sensille/conan_board/(threads)

Thread 2 (2020-06-11):

PWM11/12 labeled wrong in text

crazyimp, 2020-06-11:
PWM10 text label exists two times, text on JP4 indicates PWM12/13. What is correct?

Thread 3 (2024-12-10):

Hello, how is your conan_board built, how is mcu firmware generated, and FPGA firmware, are there any tutorials

chinaboy2277, 2024-12-10:
Hello, how is your conan_board built, how is mcu firmware generated, and FPGA firmware, are there any tutorials

sensille, 2024-12-10:
Hi, thanks for your interest in this board. I haven't done any firmware development in the past years, though I'm still using the board in my printer, but with a pretty old version of klipper.
Building the board is expensive, as you have to have the PCBs made. You also need a reflow oven or at least a hot plate for the BGA. If you really want to do all that, I can explain how to build the firmware, it is in the conan_fpga repository.

chinaboy2277, 2024-12-10:
Hello, I want to build this project, I am very interested in this project,

chinaboy2277, 2024-12-11:
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
Hello, I have registered. How can I contact you or find you?

sensille, 2024-12-11:
Hi, not LibraIrc, but Libera https://libera.chat/ thanks.

chinaboy2277, 2024-12-11:
Okay, I'll give it another try.

chinaboy2277, 2024-12-11:
Cycling to next server in Libera.Chat...
* Disconnected ()
* Looking up newserver
* Unknown host. Maybe you misspelled it?
 Cycling to next server in Libera.Chat...
* Disconnected ()
* Looking up irc.libera.chat
* Connecting to irc.libera.chat (130.185.232.126:6697)
* * Subject: /C=US/O=Internet Security Research Group/CN=ISRG Root X1
* * Issuer: /C=US/O=Internet Security Research Group/CN=ISRG Root X1
* * Subject: /C=US/O=Let's Encrypt/CN=E6
* * Issuer: /C=US/O=Internet Security Research Group/CN=ISRG Root X1
* * Subject: /CN=copper.libera.chat
* * Issuer: /C=US/O=Let's Encrypt/CN=E6
* * Certification info:
*   Subject:
*     CN=copper.libera.chat
*   Issuer:
*     C=US
*     O=Let's Encrypt
*     CN=E6
*   Public key algorithm: id-ecPublicKey (384 bits)
*   Sign algorithm ecdsa-with-SHA384
*   Valid since Oct 14 05:07:06 2024 GM to Jan 12 05:07:05 2025 GM
* * Cipher info:
*   Version: TLSv1.3, cipher TLS_AES_256_GCM_SHA384 (256 bits)
* Connected. Now logging in.
* *** Checking Ident
* *** Looking up your hostname...
* *** Couldn't look up your hostname
* *** No Ident response

sensille, 2024-12-11:
I don't know what's wrong there, maybe you can just use the webchat for a start.

chinaboy2277, 2024-12-11:
Okay, I'll look into the issue first and get back to you once I've resolved it.

sensille, 2025-01-02:
Hi, which hardware? I've seen that you joined at that time, but was too late to reach out to you.
