sensille/conan_board/conan.pdf

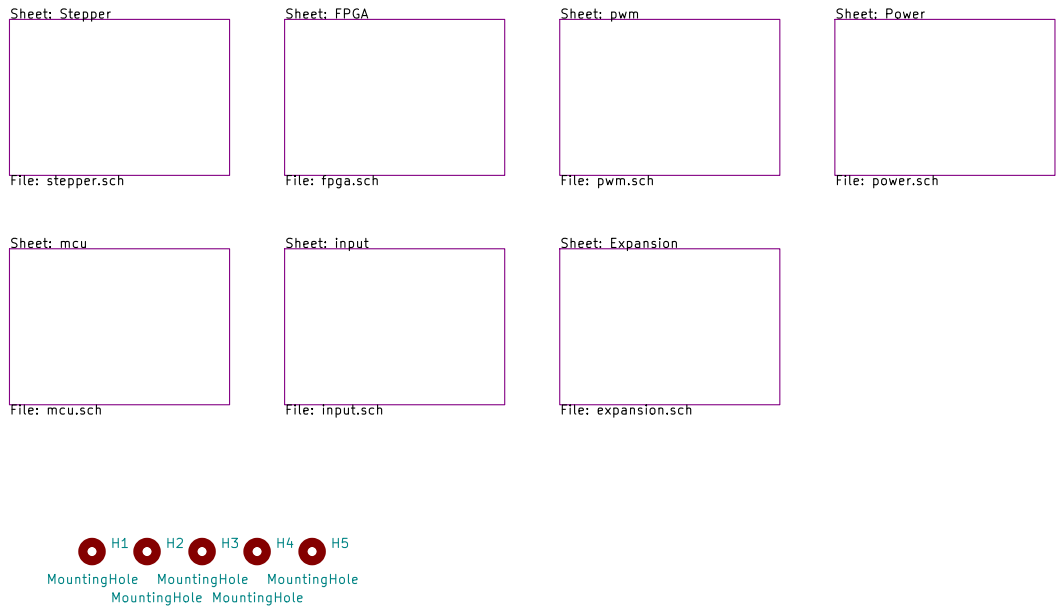
[picture p1: page 1]

Sheet: Power File: power.sch Sheet: FPGA

Id: 1/14 Title: File: conan.sch Sheet: /

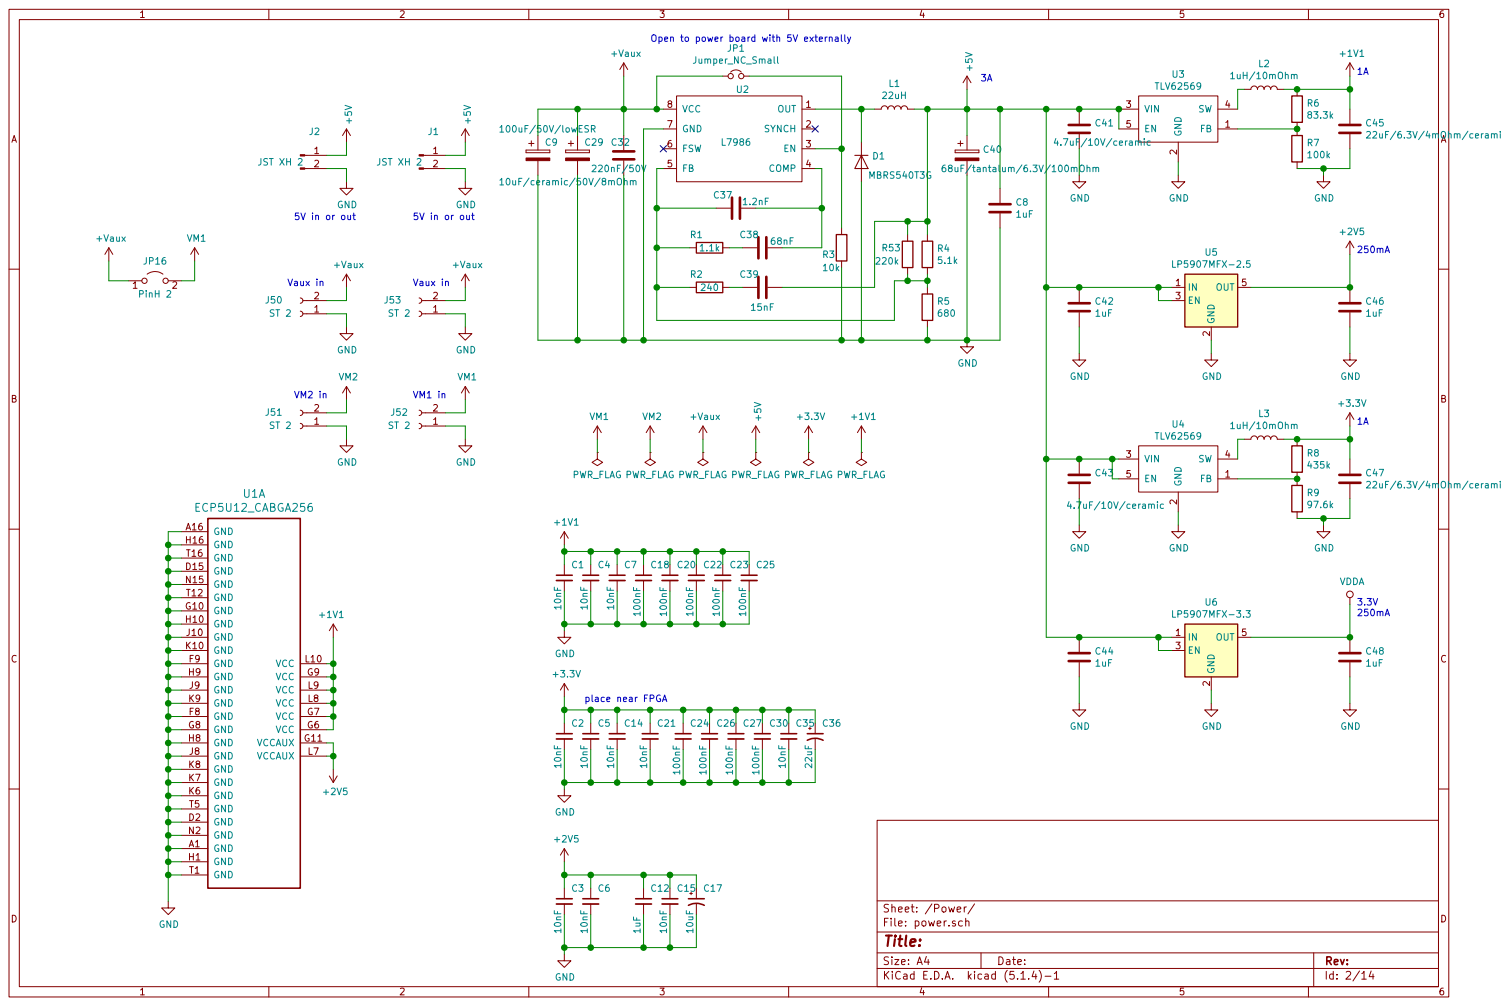
[picture p2: page 2]

3A Open to power board with 5V externally

File: power.sch Sheet: /Power/
Id: 2/14 Title:

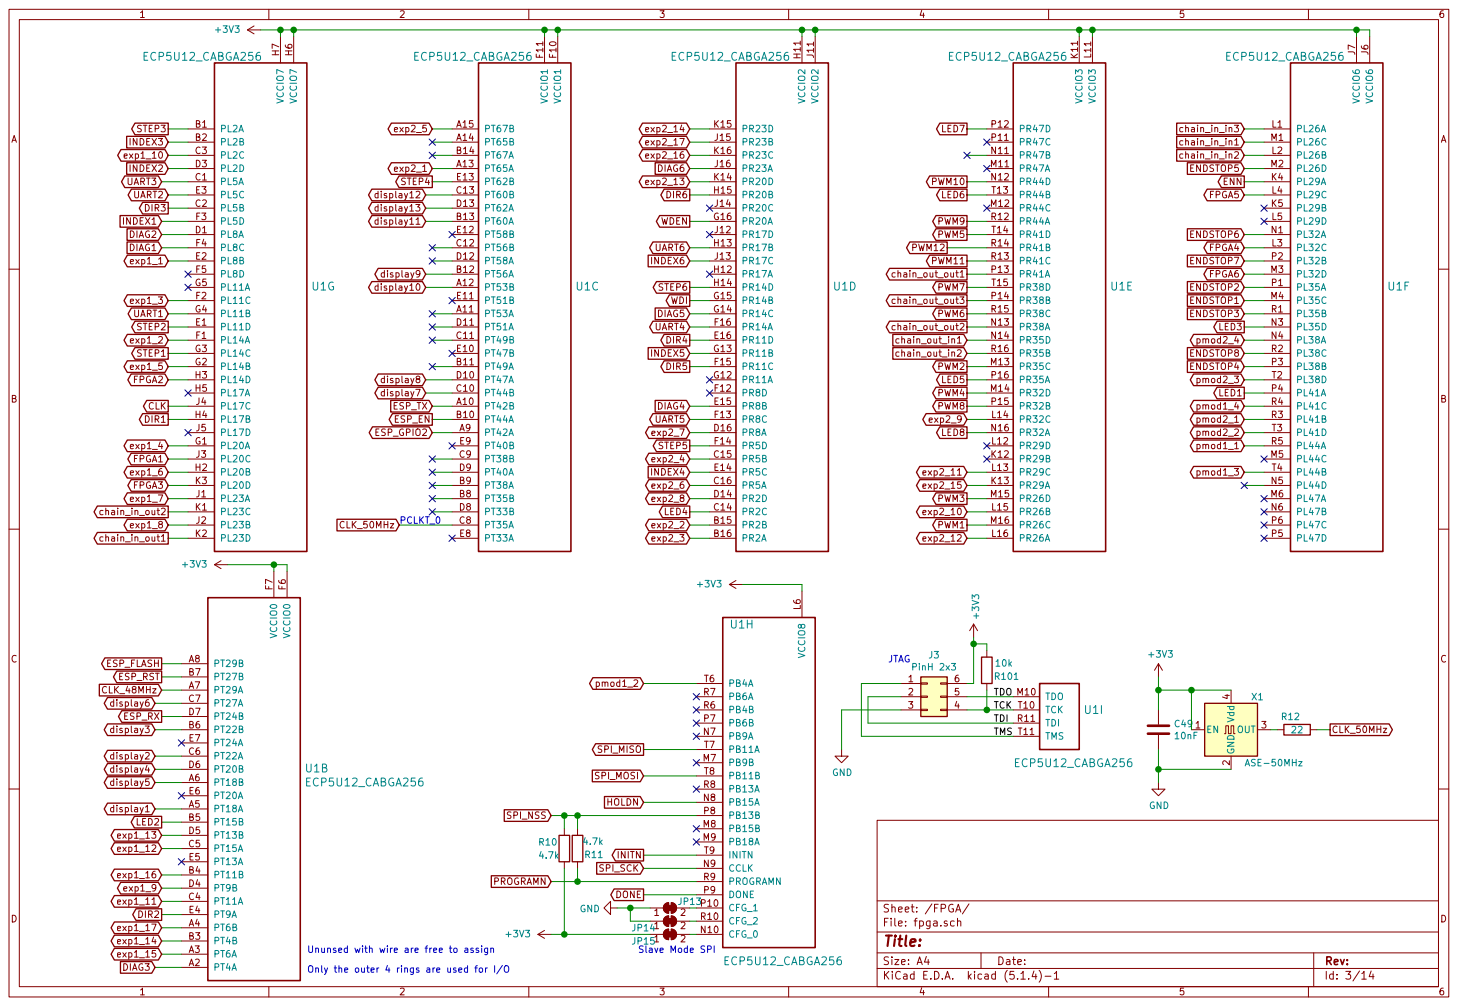
[picture p3: page 3]

TDI TMS Ununsed with wire are free to assign

Slave Mode SPI Only the outer 4 rings are used for I/O

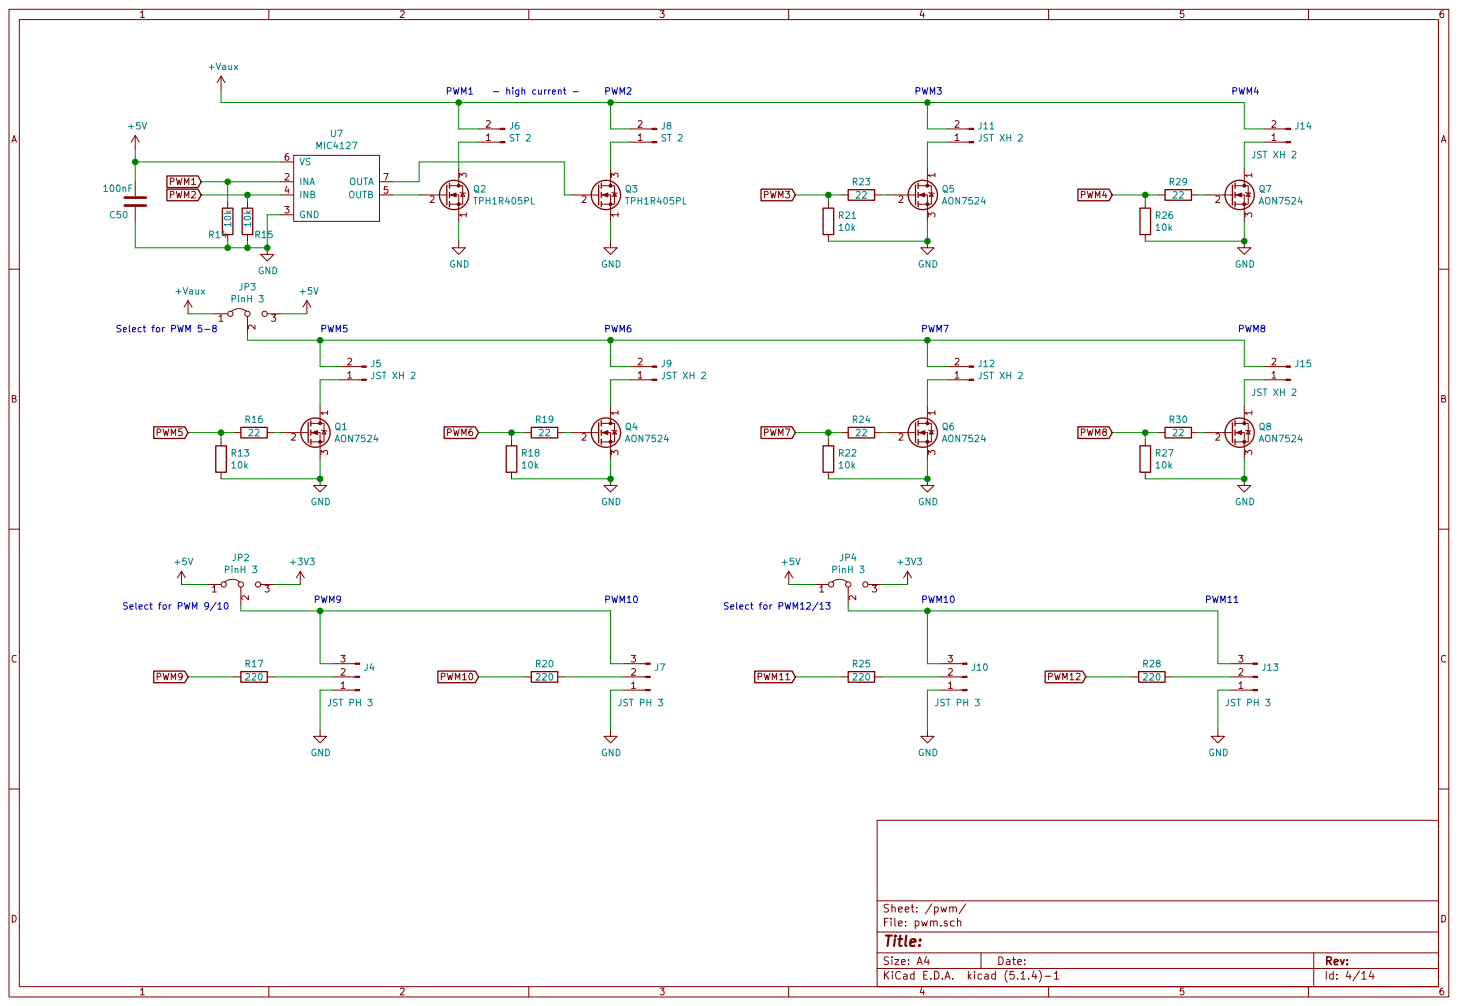
[picture p4: page 4]

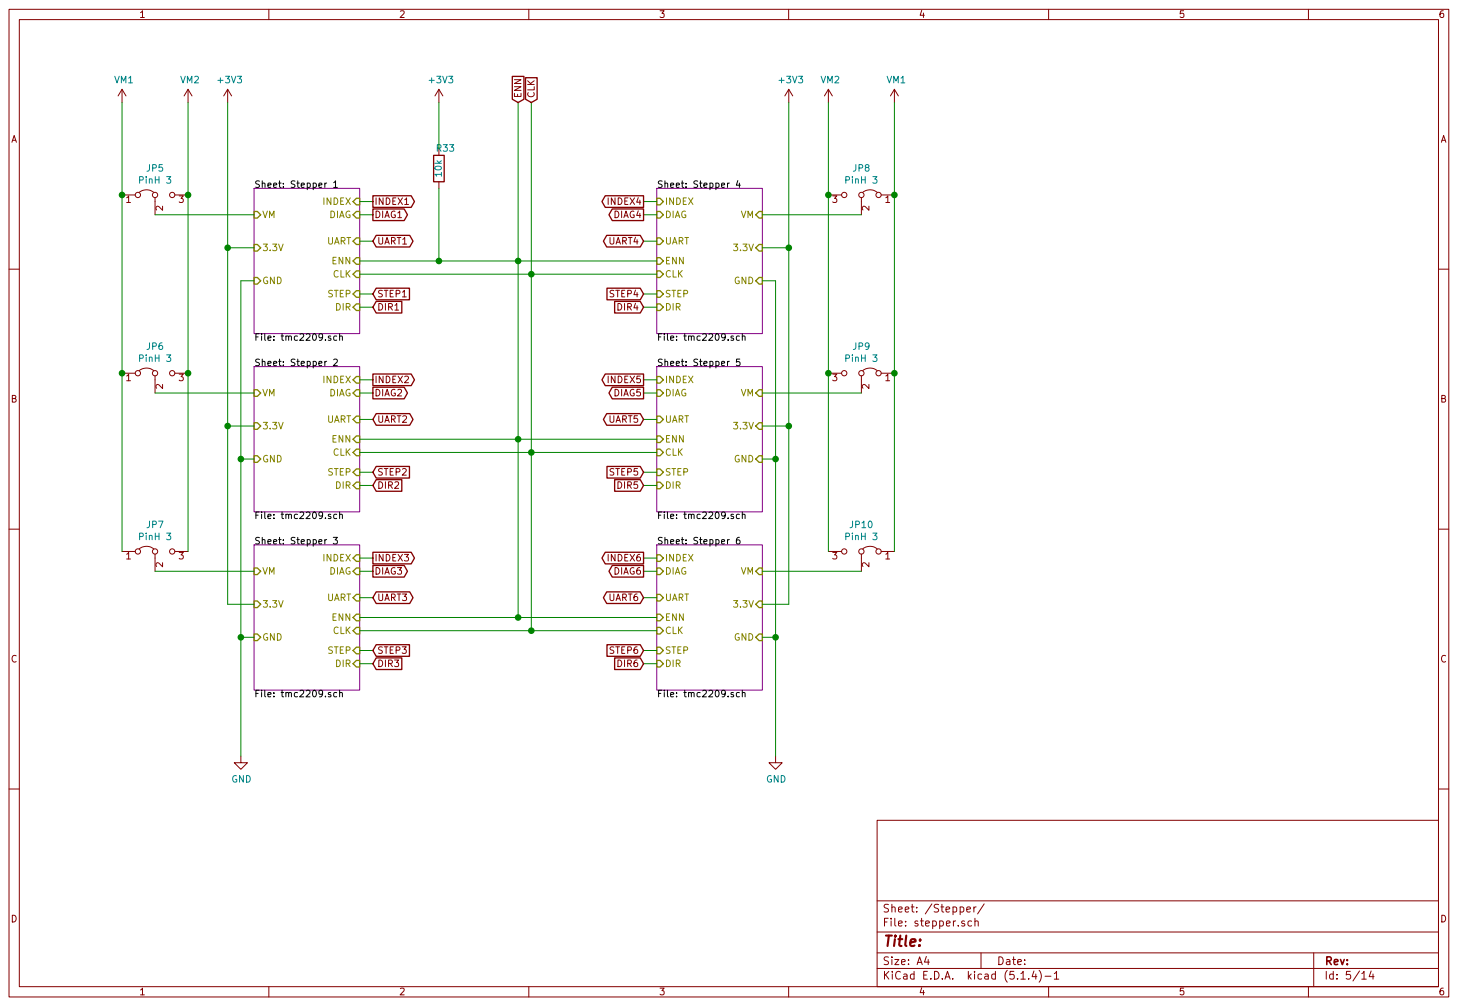
[picture p5: page 5]

Sheet: Stepper 1 File: tmc2209.sch ENN

Sheet: Stepper 4 File: tmc2209.sch ENN
UART DIAG

3.3V GND
Sheet: Stepper 5 File: tmc2209.sch ENN
INDEX

Sheet: Stepper 2 File: tmc2209.sch ENN

Sheet: Stepper 6 File: tmc2209.sch ENN

Sheet: Stepper 3 File: tmc2209.sch ENN

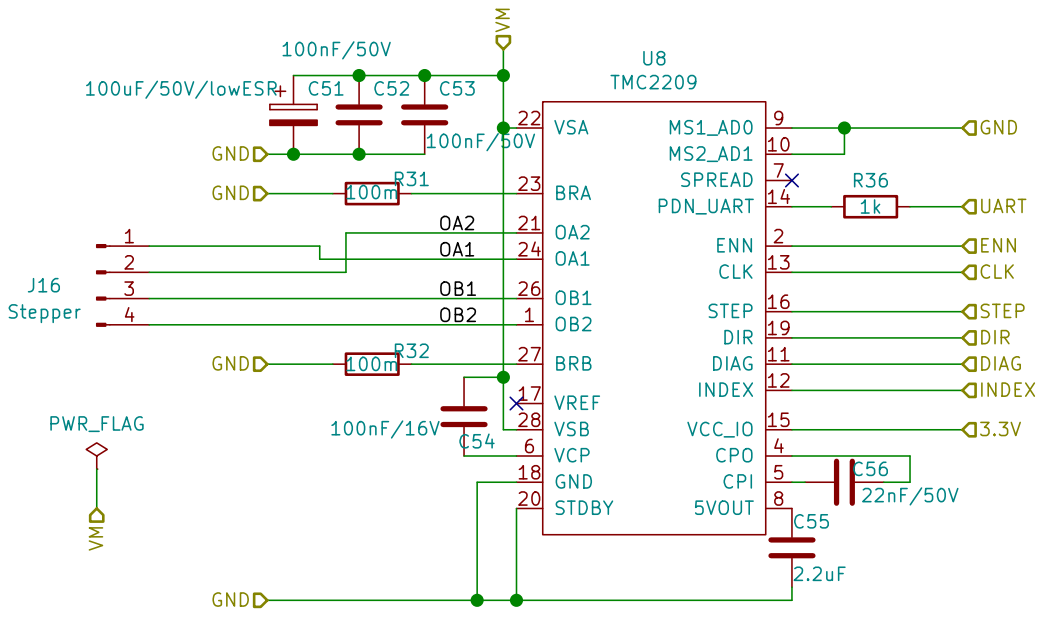
[picture p6: page 6]

Id: 6/14 Title: File: tmc2209.sch Sheet: /Stepper/Stepper 3/

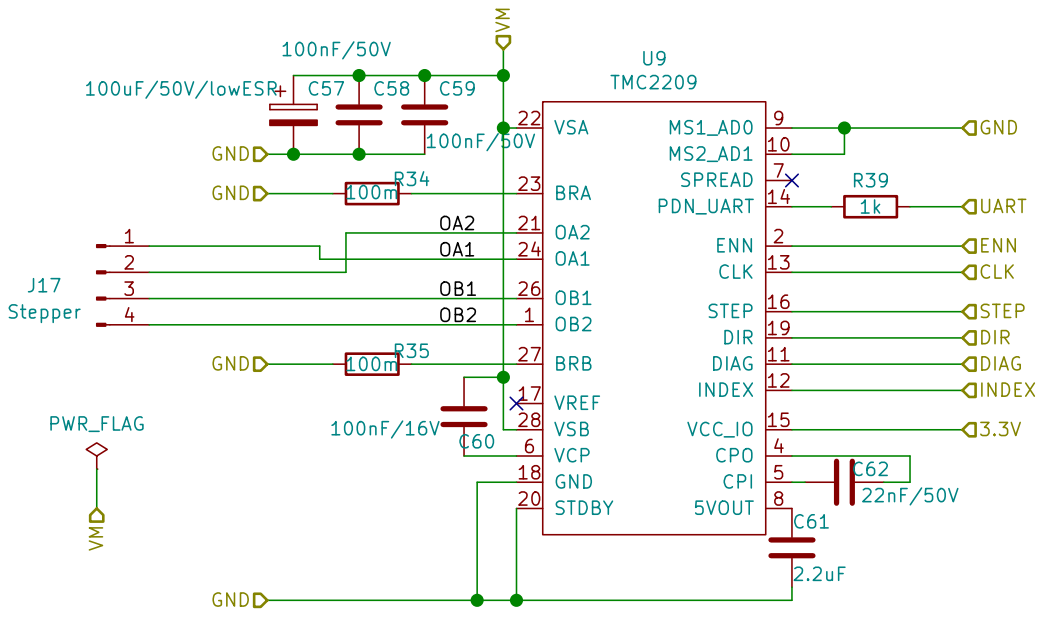
[picture p7: page 7]

Id: 7/14 Title: File: tmc2209.sch Sheet: /Stepper/Stepper 2/

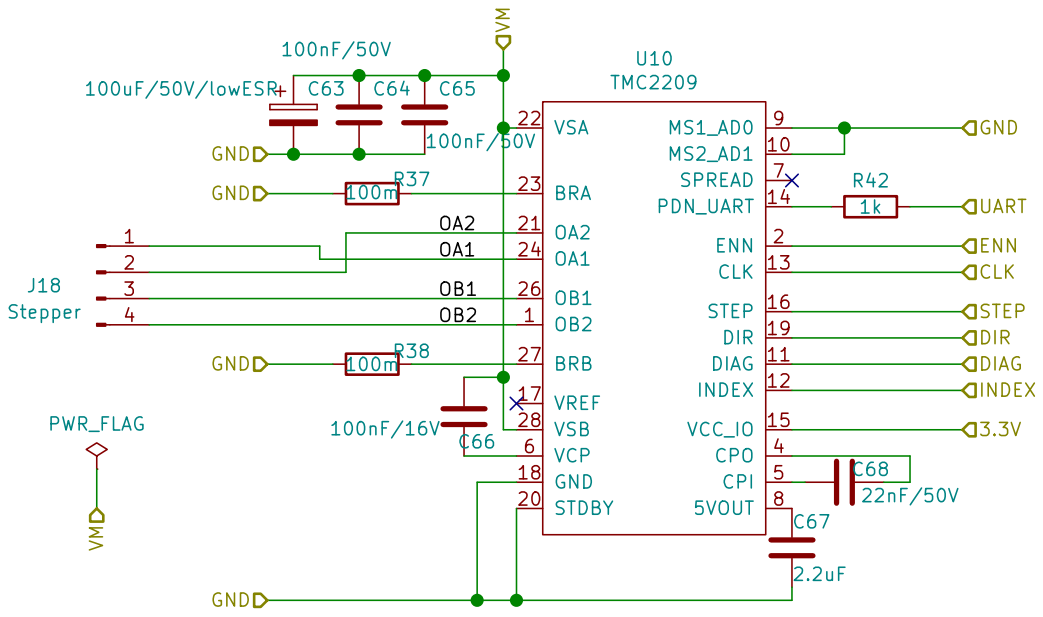
[picture p8: page 8]

Id: 8/14 Title: File: tmc2209.sch Sheet: /Stepper/Stepper 1/

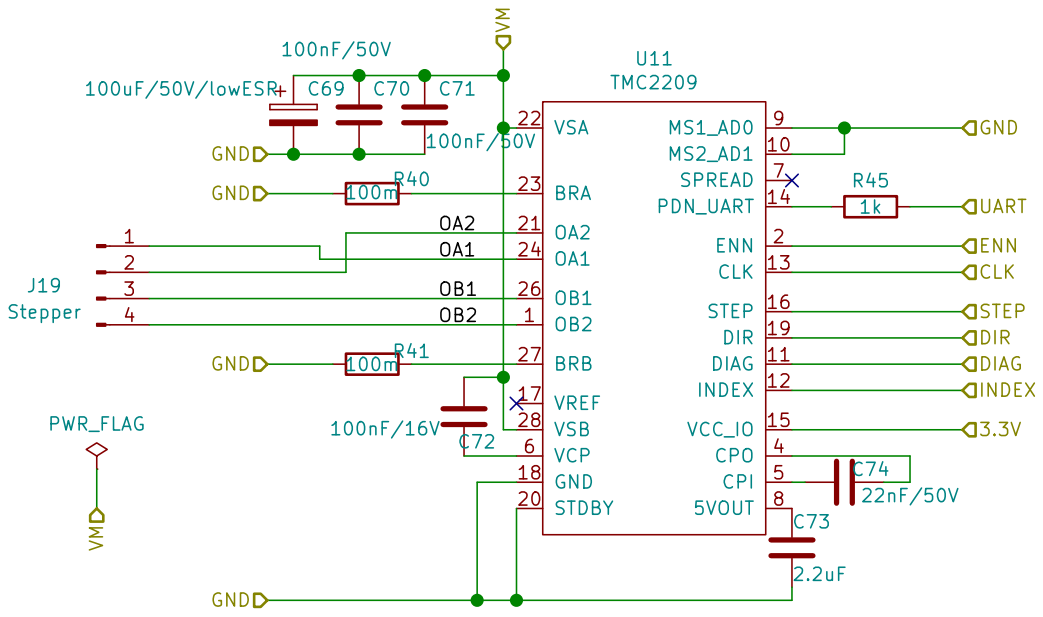
[picture p9: page 9]

Id: 9/14 Title: File: tmc2209.sch Sheet: /Stepper/Stepper 6/

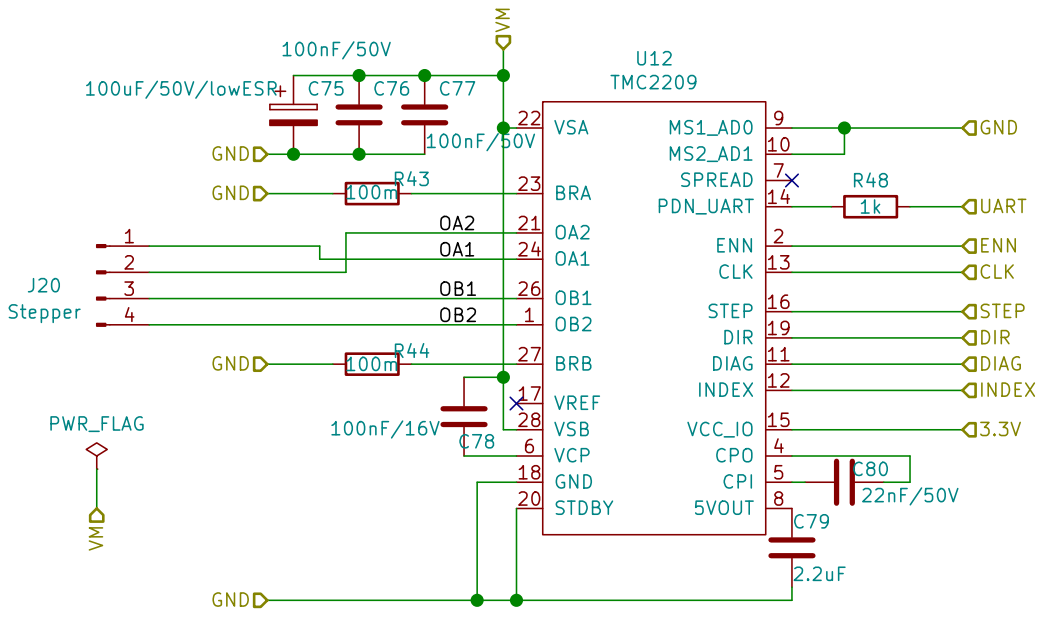
[picture p10: page 10]

Id: 10/14 Title: File: tmc2209.sch Sheet: /Stepper/Stepper 5/

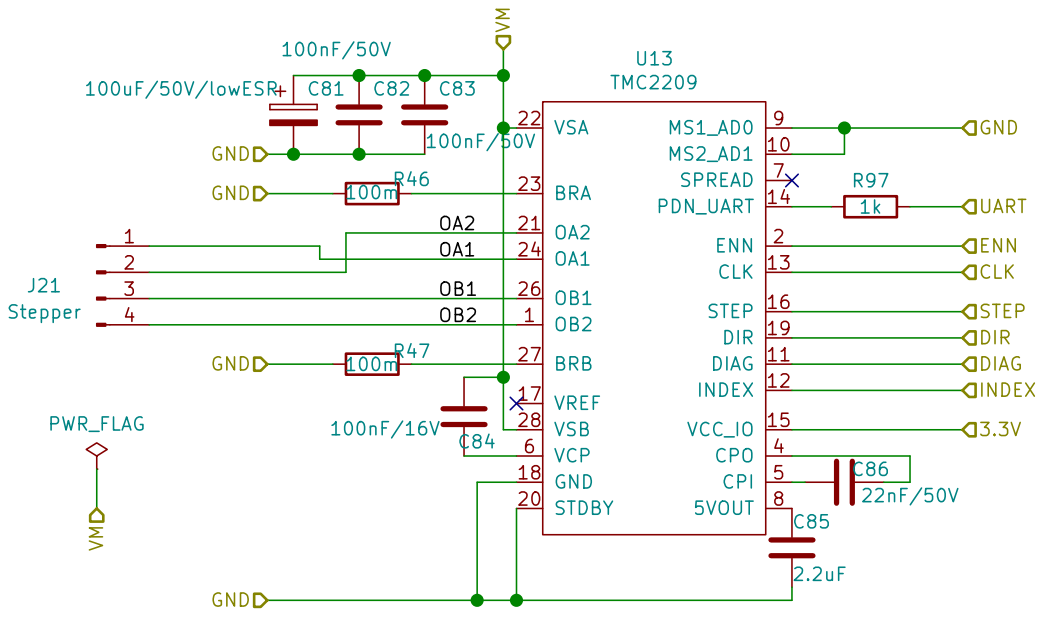
[picture p11: page 11]

Id: 11/14 Title: File: tmc2209.sch Sheet: /Stepper/Stepper 4/

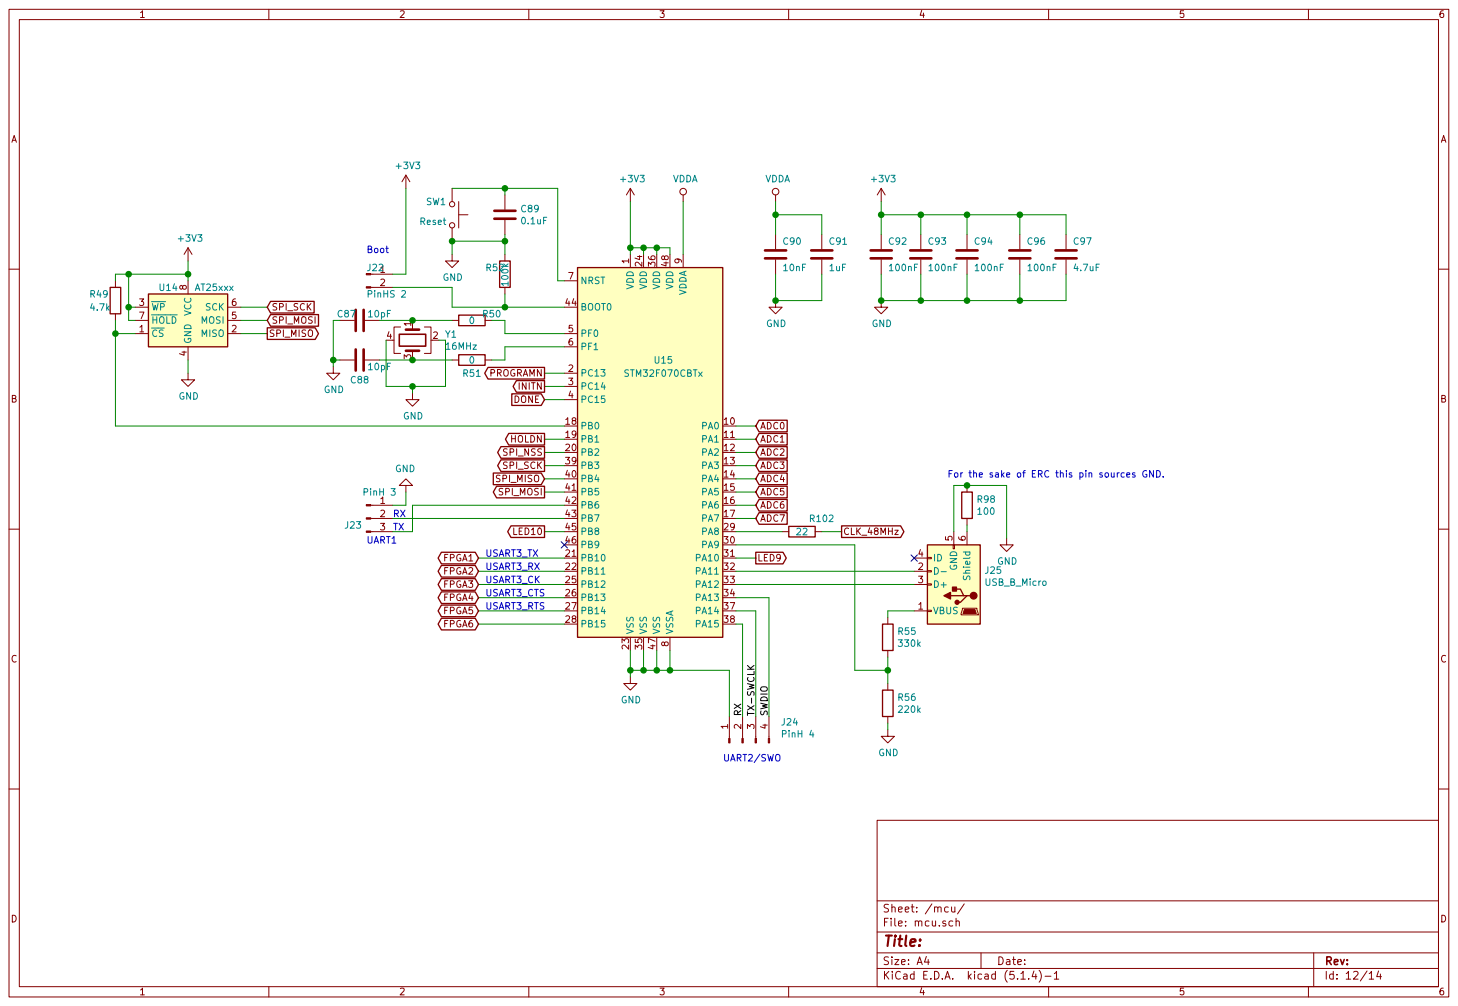
[picture p12: page 12]

1 VDD 24 VDD 36 VDD 48 VDDA

9 VSS 23 VSS 35 VSS 47 VSSA

4 MOSI 5 SCK 6 HOLD 7 VCC

For the sake of ERC this pin sources GND. RX

Id: 12/14 Title: File: mcu.sch Sheet: /mcu/

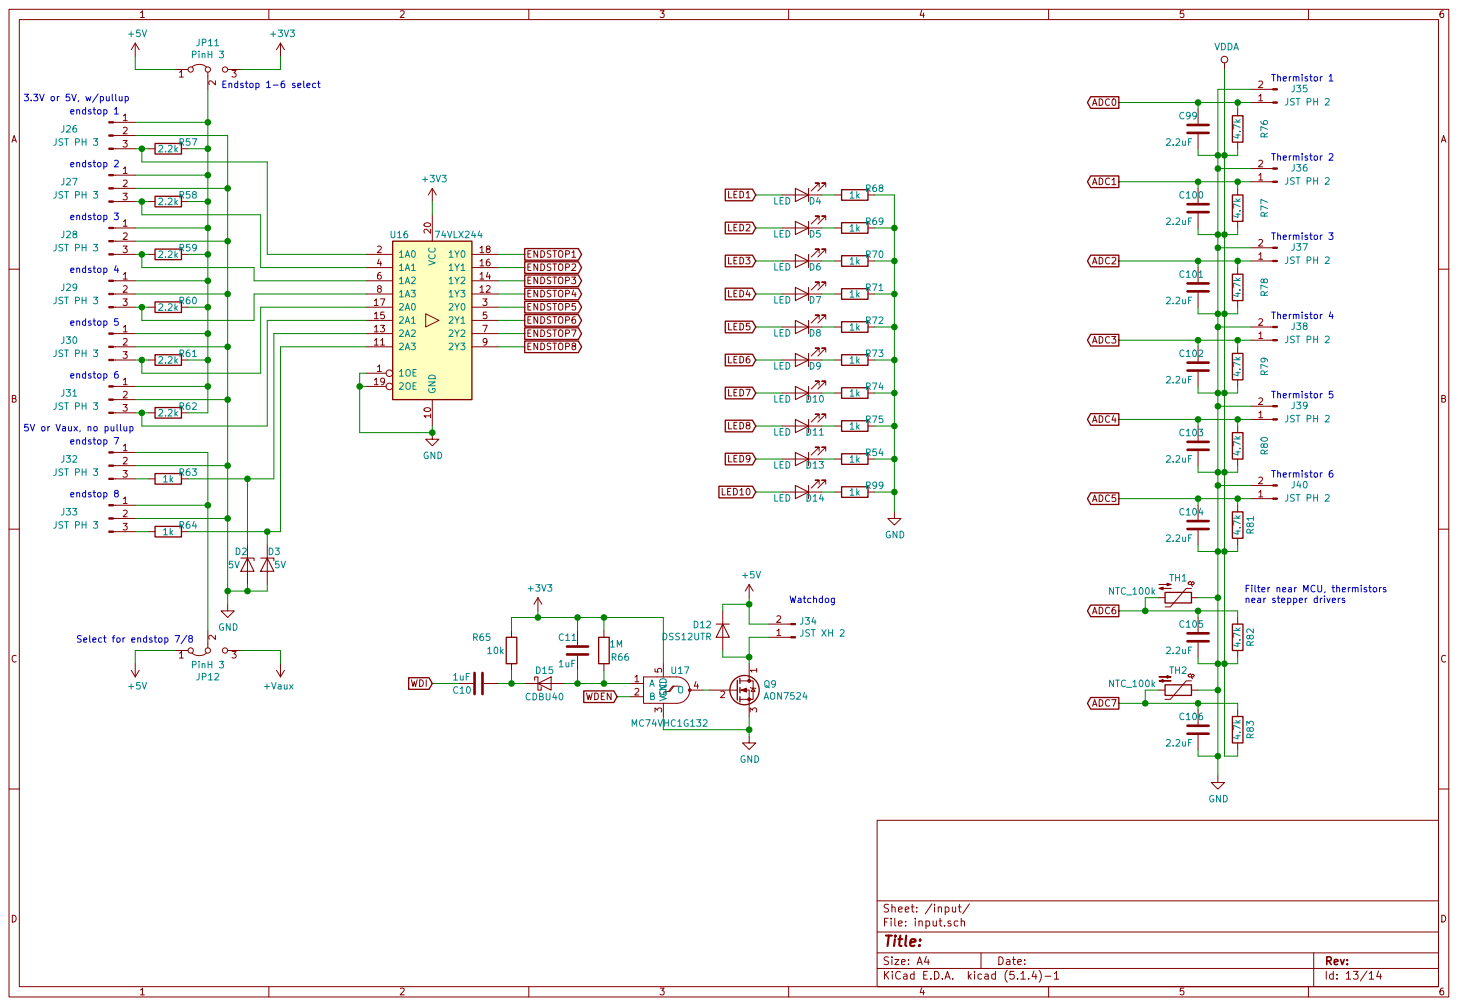
[picture p13: page 13]

5V or Vaux, no pullup

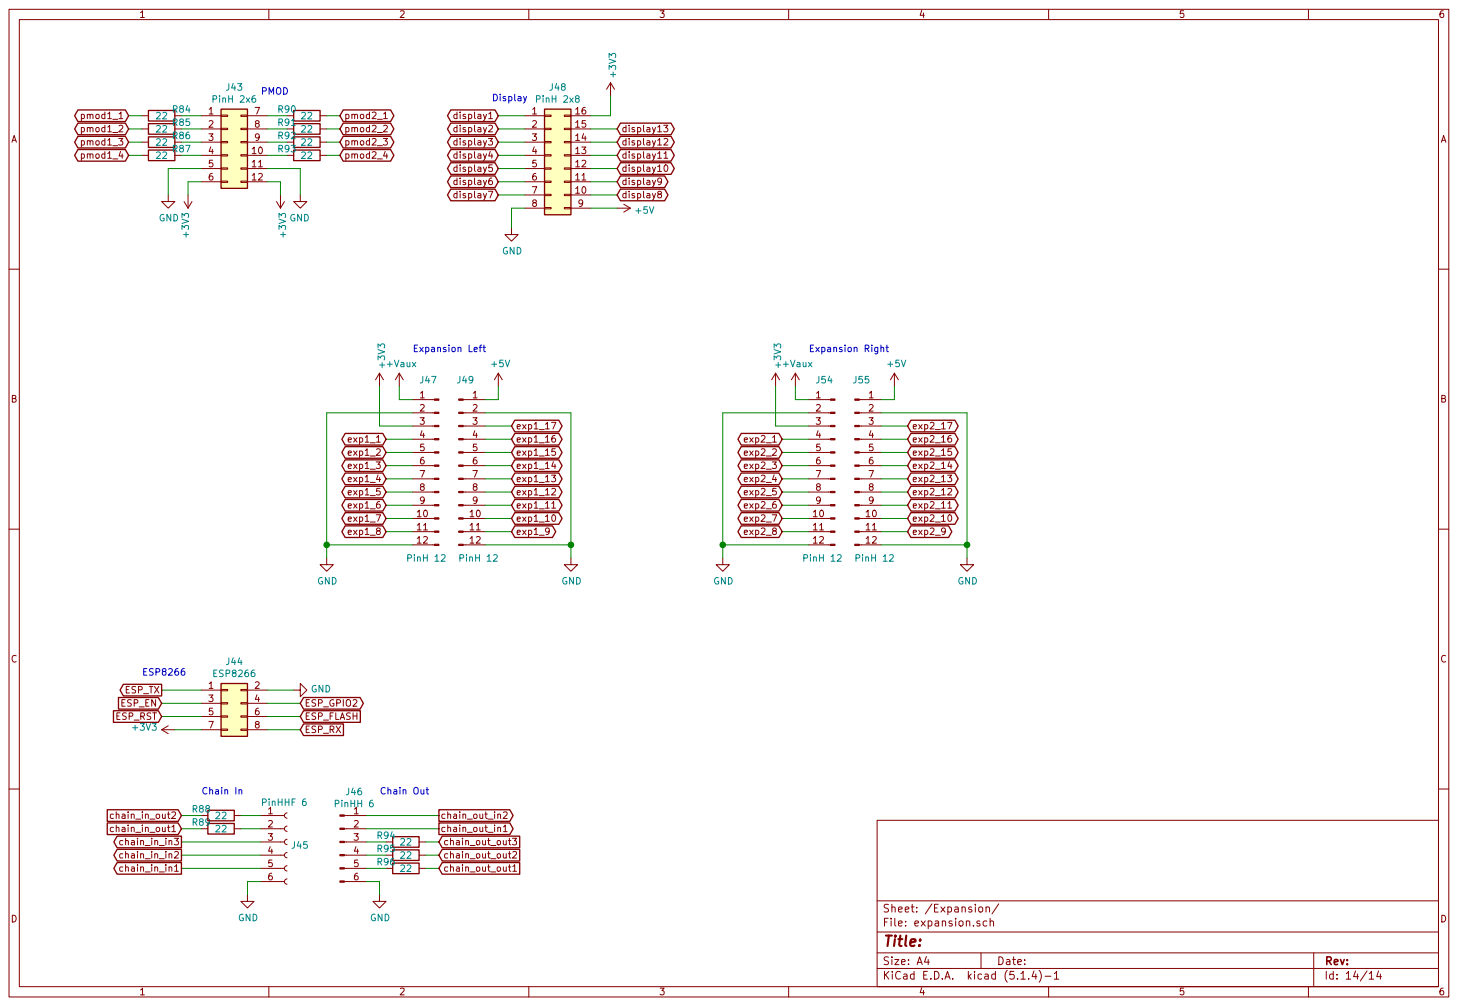
[picture p14: page 14]
