sensille/conan_board/conan.kicad_pcb

## KiCad design conan.kicad_pcb (2020-01-11)

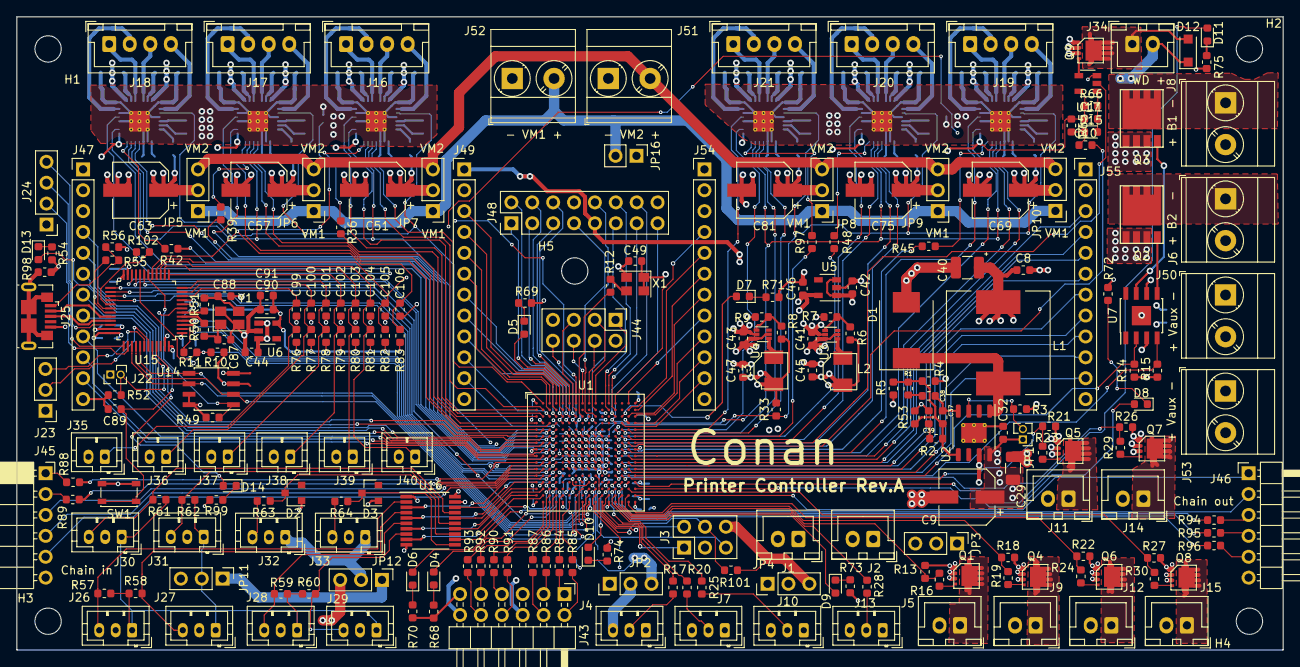
[picture p15: board conan.kicad_pcb from above]

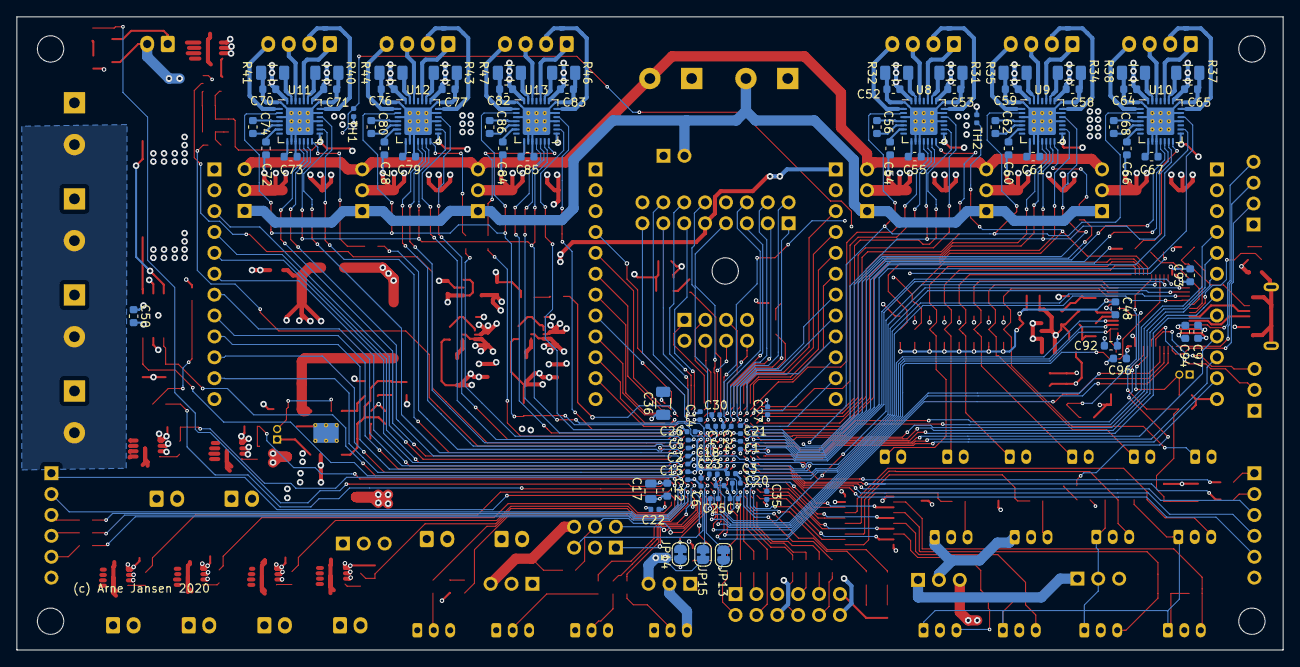
[picture p16: board conan.kicad_pcb from below]

Board: 4 copper layers, 154.0 x 77.0 mm, 320 parts (83 on the bottom side), 338 nets.

Parts:
C1, C2, C3, C4, C5, C6, C7, C14, C15, C21, C35: 10nF; C_0402_1005Metric
C8, C10, C11, C12, C42, C44, C46, C48, C91: 1uF; C_0603_1608Metric
C9, C51, C57, C63, C69, C75, C81: 100uF/50V/lowESR; CP_Elec_6.3x5.9
C17: 10uF; C_0805_2012Metric
C18, C20, C22, C23, C24, C25, C26, C27, C30: 100nF; C_0402_1005Metric
C29: 10uF/ceramic/50V/8mOhm; C_1206_3216Metric
C32: 220nF/50V; C_0603_1608Metric
C36: 22uF; C_1206_3216Metric
C37: 1.2nF; C_0603_1608Metric
C38: 68nF; C_0603_1608Metric
C39: 15nF; C_0603_1608Metric
C40: 68uF/tantalum/6.3V/100mOhm; C_1210_3225Metric
C41, C43: 4.7uF/10V/ceramic; C_0603_1608Metric
C45, C47: 22uF/6.3V/4mOhm/ceramic; C_0603_1608Metric
C49, C90: 10nF; C_0603_1608Metric
C50, C92, C93, C94, C96: 100nF; C_0603_1608Metric
C52, C53, C58, C59, C64, C65, C70, C71, C76, C77, C82, C83: 100nF/50V; C_0603_1608Metric
C54, C60, C66, C72, C78, C84: 100nF/16V; C_0603_1608Metric
C55, C61, C67, C73, C79, C85, C99, C100, C101, C102, C103, C104, C105, C106: 2.2uF; C_0603_1608Metric
C56, C62, C68, C74, C80, C86: 22nF/50V; C_0603_1608Metric
C87, C88: 10pF; C_0603_1608Metric
C89: 0.1uF; C_0603_1608Metric
C97: 4.7uF; C_0603_1608Metric
D1: MBRS540T3G; D_SMC
D2, D3: 5V; D_SOT-23_ANK
D4, D5, D6, D7, D8, D9, D10, D11, D13, D14: LED; LED_0603_1608Metric
D12: DSS12UTR; D_SOD-123F
D15: CDBU40; D_0603_1608Metric
H1, H2, H3, H4, H5: MountingHole; MountingHole_3.2mm_M3
J1, J2, J5, J9, J11, J12, J14, J15, J34: JST XH 2; JST_XH_B02B-XH-A_1x02_P2.50mm_Vertical
J3: PinH 2x3; PinHeader_2x03_P2.54mm_Vertical
J4, J7, J10, J13, J26, J27, J28, J29, J30, J31, J32, J33: JST PH 3; JST_PH_B3B-PH-K_1x03_P2.00mm_Vertical
J6, J8, J50, J51, J52, J53: ST 2; TerminalBlock_Phoenix_MKDS-3-2-5.08_1x02_P5.08mm_Horizontal
J16, J17, J18, J19, J20, J21: Stepper; JST_XH_B04B-XH-A_1x04_P2.50mm_Vertical
J22: PinHS 2; PinHeader_1x02_P1.27mm_Vertical
J23: PinH 3; PinHeader_1x03_P2.54mm_Vertical
J24: PinH 4; PinHeader_1x04_P2.54mm_Vertical
J25: USB_B_Micro; USB_Micro-B_GCT_USB3076-30-A
J35, J36, J37, J38, J39, J40: JST PH 2; JST_PH_B2B-PH-K_1x02_P2.00mm_Vertical
J43: PinH 2x6; PinHeader_2x06_P2.54mm_Horizontal
J44: ESP8266; PinHeader_2x04_P2.54mm_Vertical
J45: PinHHF 6; PinSocket_1x06_P2.54mm_Horizontal
J46: PinHH 6; PinHeader_1x06_P2.54mm_Horizontal
J47, J49, J54, J55: PinH 12; PinHeader_1x12_P2.54mm_Vertical
J48: PinH 2x8; PinHeader_2x08_P2.54mm_Vertical
JP1: Jumper_NC_Small; PinHeader_1x02_P1.27mm_Vertical
JP2, JP3, JP4, JP5, JP6, JP7, JP8, JP9, JP10, JP11, JP12: PinH 3; PinHeader_1x03_P2.54mm_Vertical
JP13, JP14, JP15: SolderJumper-2_P1.3mm_Bridged_RoundedPad1.0x1.5mm
JP16: PinH 2; PinHeader_1x02_P2.54mm_Vertical
L1: 22uH; L_Wuerth_WE-PD-Typ-LS
L2, L3: 1uH/10mOhm; SPM4012-LR
Q1, Q4, Q5, Q6, Q7, Q8, Q9: AON7524; FET_DGS_DFN3x3A_8L_EP1_P
Q2, Q3: TPH1R405PL; TPH1R405PL_SGD
R1: 1.1k; R_0603_1608Metric
R2: 240; R_0603_1608Metric
R3, R13, R14, R15, R18, R21, R22, R26, R27, R33, R65, R101: 10k; R_0603_1608Metric
R4: 5.1k; R_0603_1608Metric
R5: 680; R_0603_1608Metric
R6: 83.3k; R_0603_1608Metric
R7, R52: 100k; R_0603_1608Metric
R8: 435k; R_0603_1608Metric
R9: 97.6k; R_0603_1608Metric
R10, R11, R49, R76, R77, R78, R79, R80, R81, R82, R83: 4.7k; R_0603_1608Metric
R12, R16, R19, R23, R24, R29, R30, R84, R85, R86, R87, R88, R89, R90, R91, R92, R93, R94, R95, R96, R102: 22; R_0603_1608Metric
R17, R20, R25, R28: 220; R_0603_1608Metric
R31, R32, R34, R35, R37, R38, R40, R41, R43, R44, R46, R47: 100m; R_1206_3216Metric
R36, R39, R42, R45, R48, R54, R63, R64, R68, R69, R70, R71, R72, R73, R74, R75, R97, R99: 1k; R_0603_1608Metric
R50, R51: 0; R_0603_1608Metric
R53, R56: 220k; R_0603_1608Metric
R55: 330k; R_0603_1608Metric
R57, R58, R59, R60, R61, R62: 2.2k; R_0603_1608Metric
R66: 1M; R_0603_1608Metric
R98: 100; R_0603_1608Metric
SW1: Reset; SW_SPST_PTS810
TH1, TH2: NTC_100k; R_0402_1005Metric
U1: ECP5U12_CABGA256; BGA-256_14.0x14.0mm_Layout16x16_P0.8mm_Ball0.45mm_Pad0.32mm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
U2: L7986; HSOP-8-1EP_3.9x4.9mm_P1.27mm_EP2.41x3.1mm_ThermalVias
U3, U4: TLV62569; SOT-563
U5: LP5907MFX-2.5; SOT-23-5
U6: LP5907MFX-3.3; SOT-23-5
U7: MIC4127; SOIC-8-1EP_3.9x4.9mm_P1.27mm_EP2.35x2.35mm
U8, U9, U10, U11, U12, U13: TMC2209; QFN-28-1EP_5x5mm_P0.5mm_EP3.35x3.35mm_ThermalVias
U14: AT25xxx; SOIC-8_3.9x4.9mm_P1.27mm
U15: STM32F070CBTx; LQFP-48_7x7mm_P0.5mm
U16: 74VLX244; TSSOP-20_4.4x6.5mm_P0.65mm
U17: MC74VHC1G132; SOT-23-5
X1: ASE-50MHz; Oscillator_SMD_Abracon_ASE-4Pin_3.2x2.5mm
Y1: 16MHz; Crystal_SMD_SeikoEpson_TSX3225-4Pin_3.2x2.5mm

Connections:
+1V1: C1.1, C4.1, C7.1, C18.1, C20.1, C22.1, C23.1, C25.1, C45.1, L2.2, R6.1, U1.G6, U1.G7, U1.G9, U1.L8, U1.L9, U1.L10
+2V5: C3.1, C6.1, C12.1, C15.1, C17.1, C46.1, U1.G11, U1.L7, U5.5
+3V3: C2.1, C5.1, C11.1, C14.1, C21.1, C24.1, C26.1, C27.1, C30.1, C35.1, C36.1, C47.1, C49.1, C92.1, C93.1, C94.1, C96.1, C97.1, J3.6, J22.1, J43.6, J43.12, J44.7, J47.3, J48.16, J54.3, JP2.3, JP4.3, JP11.3, JP15.1, L3.2, R8.1, R10.2, R33.2, R49.1, R65.1, R66.1, R101.2, U1.F6, U1.F7, U1.F10, U1.F11, U1.H6, U1.H7, U1.H11, U1.J6, U1.J7, U1.J11, U1.K11, U1.L6, U1.L11, U8.15, U9.15, U10.15, U11.15, U12.15, U13.15, U14.3, U14.7, U14.8, U15.1, U15.24, U15.36, U15.48, U16.20, U17.5, X1.1, X1.4
+5V: C8.1, C39.1, C40.1, C41.1, C42.1, C43.1, C44.1, C50.1, D12.1, J1.1, J2.1, J34.2, J48.9, J49.1, J55.1, JP2.1, JP3.3, JP4.1, JP11.1, JP12.1, L1.2, R4.1, R53.1, U3.3, U3.5, U4.3, U4.5, U5.1, U5.3, U6.1, U6.3, U7.6
+VM1: J52.2, JP5.1, JP6.1, JP7.1, JP8.1, JP9.1, JP10.1, JP16.2
+VM2: J51.2, JP5.3, JP6.3, JP7.3, JP8.3, JP9.3, JP10.3
+Vaux: C9.1, C29.1, C32.1, J6.2, J8.2, J11.2, J14.2, J47.1, J50.2, J53.2, J54.1, JP1.1, JP3.1, JP12.3, JP16.1, U2.8
/FPGA/TCK: J3.4, R101.1, U1.T10
/FPGA/TDI: J3.2, U1.R11
/FPGA/TDO: J3.5, U1.M10
/FPGA/TMS: J3.1, U1.T11
/Stepper/Stepper 1/OA1: J18.1, U10.24
/Stepper/Stepper 1/OA2: J18.2, U10.21
/Stepper/Stepper 1/OB1: J18.3, U10.26
/Stepper/Stepper 1/OB2: J18.4, U10.1
/Stepper/Stepper 1/VM: C63.1, C64.1, C65.1, C66.2, JP5.2, U10.22, U10.28
/Stepper/Stepper 2/OA1: J17.1, U9.24
/Stepper/Stepper 2/OA2: J17.2, U9.21
/Stepper/Stepper 2/OB1: J17.3, U9.26
/Stepper/Stepper 2/OB2: J17.4, U9.1
/Stepper/Stepper 2/VM: C57.1, C58.1, C59.1, C60.2, JP6.2, U9.22, U9.28
/Stepper/Stepper 3/OA1: J16.1, U8.24
/Stepper/Stepper 3/OA2: J16.2, U8.21
/Stepper/Stepper 3/OB1: J16.3, U8.26
/Stepper/Stepper 3/OB2: J16.4, U8.1
/Stepper/Stepper 3/VM: C51.1, C52.1, C53.1, C54.2, JP7.2, U8.22, U8.28
/Stepper/Stepper 4/OA1: J21.1, U13.24
/Stepper/Stepper 4/OA2: J21.2, U13.21
/Stepper/Stepper 4/OB1: J21.3, U13.26
/Stepper/Stepper 4/OB2: J21.4, U13.1
/Stepper/Stepper 4/VM: C81.1, C82.1, C83.1, C84.2, JP8.2, U13.22, U13.28
/Stepper/Stepper 5/OA1: J20.1, U12.24
/Stepper/Stepper 5/OA2: J20.2, U12.21
/Stepper/Stepper 5/OB1: J20.3, U12.26
/Stepper/Stepper 5/OB2: J20.4, U12.1
/Stepper/Stepper 5/VM: C75.1, C76.1, C77.1, C78.2, JP9.2, U12.22, U12.28
/Stepper/Stepper 6/OA1: J19.1, U11.24
/Stepper/Stepper 6/OA2: J19.2, U11.21
/Stepper/Stepper 6/OB1: J19.3, U11.26
/Stepper/Stepper 6/OB2: J19.4, U11.1
/Stepper/Stepper 6/VM: C69.1, C70.1, C71.1, C72.2, JP10.2, U11.22, U11.28
/mcu/RX: J24.2, U15.38
/mcu/SWDIO: J24.4, U15.34
/mcu/TX-SWCLK: J24.3, U15.37
ADC0: C99.1, J35.1, R76.2, U15.10
ADC1: C100.1, J36.1, R77.2, U15.11
ADC2: C101.1, J37.1, R78.2, U15.12
ADC3: C102.1, J38.1, R79.2, U15.13
ADC4: C103.1, J39.1, R80.2, U15.14
ADC5: C104.1, J40.1, R81.2, U15.15
ADC6: C105.1, R82.2, TH1.2, U15.16
ADC7: C106.1, R83.2, TH2.2, U15.17
CLK: U1.J4, U8.13, U9.13, U10.13, U11.13, U12.13, U13.13
CLK_48MHz: R102.1, U1.A7
CLK_50MHz: R12.1, U1.C8
DIAG1: U1.F4, U10.11
DIAG2: U1.D1, U9.11
DIAG3: U1.A2, U8.11
DIAG4: U1.E15, U13.11
DIAG5: U1.G14, U12.11
DIAG6: U1.J16, U11.11
DIR1: U1.H4, U10.19
DIR2: U1.E4, U9.19
DIR3: U1.C2, U8.19
DIR4: U1.E16, U13.19
DIR5: U1.F15, U12.19
DIR6: U1.H15, U11.19
DONE: U1.P9, U15.4
ENDSTOP1: U1.M4, U16.18
ENDSTOP2: U1.P1, U16.16
ENDSTOP3: U1.R1, U16.14
ENDSTOP4: U1.P3, U16.12
ENDSTOP5: U1.M2, U16.3
ENDSTOP6: U1.N1, U16.5
ENDSTOP7: U1.P2, U16.7
ENDSTOP8: U1.R2, U16.9
ENN: R33.1, U1.K4, U8.2, U9.2, U10.2, U11.2, U12.2, U13.2
ESP_EN: J44.3, U1.B10
ESP_FLASH: J44.6, U1.A8
ESP_GPIO2: J44.4, U1.A9
ESP_RST: J44.5, U1.B7
ESP_RX: J44.8, U1.D7
ESP_TX: J44.1, U1.A10
FPGA1: U1.J3, U15.21
FPGA2: U1.H3, U15.22
FPGA3: U1.K3, U15.25
FPGA4: U1.L3, U15.26
FPGA5: U1.L4, U15.27
FPGA6: U1.M3, U15.28
GND: C1.2, C2.2, C3.2, C4.2, C5.2, C6.2, C7.2, C8.2, C9.2, C12.2, C14.2, C15.2, C17.2, C18.2, C20.2, C21.2, C22.2, C23.2, C24.2, C25.2, C26.2, C27.2, C29.2, C30.2, C32.2, C35.2, C36.2, C40.2, C41.2, C42.2, C43.2, C44.2, C45.2, C46.2, C47.2, C48.2, C49.2, C50.2, C51.2, C52.2, C53.2, C55.2, C57.2, C58.2, C59.2, C61.2, C63.2, C64.2, C65.2, C67.2, C69.2, C70.2, C71.2, C73.2, C75.2, C76.2, C77.2, C79.2, C81.2, C82.2, C83.2, C85.2, C87.2, C88.2, C89.2, C90.2, C91.2, C92.2, C93.2, C94.2, C96.2, C97.2, C99.2, C100.2, C101.2, C102.2, C103.2, C104.2, C105.2, C106.2, D1.2, D2.2, D3.2, J1.2, J2.2, J3.3, J4.1, J7.1, J10.1, J13.1, J23.1, J24.1, J25.5, J26.2, J27.2, J28.2, J29.2, J30.2, J31.2, J32.2, J33.2, J35.2, J36.2, J37.2, J38.2, J39.2, J40.2, J43.5, J43.11, J44.2, J45.6, J46.6, J47.2, J47.12, J48.8, J49.2, J49.12, J50.1, J51.1, J52.1, J53.1, J54.2, J54.12, J55.2, J55.12, JP13.1, JP14.1, Q1.3, Q2.1, Q3.1, Q4.3, Q5.3, Q6.3, Q7.3, Q8.3, Q9.3, R3.2, R5.2, R7.2, R9.2, R13.2, R14.2, R15.2, R18.2, R21.2, R22.2, R26.2, R27.2, R31.2, R32.2, R34.2, R35.2, R37.2, R38.2, R40.2, R41.2, R43.2, R44.2, R46.2, R47.2, R52.1, R54.1, R56.2, R68.1, R69.1, R70.1, R71.1, R72.1, R73.1, R74.1, R75.1, R98.1, R99.1, SW1.2, TH1.1, TH2.1, U1.A1, U1.A16, U1.D2, U1.D15, U1.F8, U1.F9, U1.G8, U1.G10, U1.H1, U1.H8, U1.H9, U1.H10, U1.H16, U1.J8, U1.J9, U1.J10, U1.K6, U1.K7, U1.K8, U1.K9, U1.K10, U1.N2, U1.N15, U1.T1, U1.T5, U1.T12, U1.T16, U2.7, U2.9, U3.2, U4.2, U5.2, U6.2, U7.3, U7.9, U8.3, U8.9, U8.10, U8.18, U8.20, U8.29, U9.3, U9.9, U9.10, U9.18, U9.20, U9.29, U10.3, U10.9, U10.10, U10.18, U10.20, U10.29, U11.3, U11.9, U11.10, U11.18, U11.20, U11.29, U12.3, U12.9, U12.10, U12.18, U12.20, U12.29, U13.3, U13.9, U13.10, U13.18, U13.20, U13.29, U14.4, U15.8, U15.23, U15.35, U15.47, U16.1, U16.10, U16.19, U17.3, X1.2, Y1.2, Y1.4
HOLDN: U1.N8, U15.19
INDEX1: U1.F3, U10.12
INDEX2: U1.D3, U9.12
INDEX3: U1.B2, U8.12
INDEX4: U1.E14, U13.12
INDEX5: U1.G13, U12.12
INDEX6: U1.J13, U11.12
INITN: U1.T9, U15.3
LED1: D4.2, U1.P4
LED2: D5.2, U1.B5
LED3: D6.2, U1.N3
LED4: D7.2, U1.C14
LED5: D8.2, U1.P16
LED6: D9.2, U1.T13
LED7: D10.2, U1.P12
LED8: D11.2, U1.N16
LED9: D13.2, U15.31
LED10: D14.2, U15.45
unnamed: C10.1, D15.1, R65.2
unnamed: C11.2, D15.2, R66.2, U17.1
unnamed: C37.1, C38.1, U2.4
unnamed: C37.2, R1.2, R2.2, R4.2, R5.1, R53.2, U2.5
unnamed: C38.2, R1.1
unnamed: C39.2, R2.1
unnamed: C54.1, U8.6
unnamed: C55.1, U8.8
unnamed: C56.1, U8.4
unnamed: C56.2, U8.5
unnamed: C60.1, U9.6
unnamed: C61.1, U9.8
unnamed: C62.1, U9.4
unnamed: C62.2, U9.5
unnamed: C66.1, U10.6
unnamed: C67.1, U10.8
unnamed: C68.1, U10.4
unnamed: C68.2, U10.5
unnamed: C72.1, U11.6
unnamed: C73.1, U11.8
unnamed: C74.1, U11.4
unnamed: C74.2, U11.5
unnamed: C78.1, U12.6
unnamed: C79.1, U12.8
unnamed: C80.1, U12.4
unnamed: C80.2, U12.5
unnamed: C84.1, U13.6
unnamed: C85.1, U13.8
unnamed: C86.1, U13.4
unnamed: C86.2, U13.5
unnamed: C87.1, R50.2, Y1.1
unnamed: C88.1, R51.2, Y1.3
unnamed: C89.1, SW1.1, U15.7
unnamed: D1.1, L1.1, U2.1
unnamed: D2.1, R63.1, U16.13
unnamed: D3.1, R64.1, U16.11
unnamed: D4.1, R68.2
unnamed: D5.1, R69.2
unnamed: D6.1, R70.2
unnamed: D7.1, R71.2
unnamed: D8.1, R72.2
unnamed: D9.1, R73.2
unnamed: D10.1, R74.2
unnamed: D11.1, R75.2
unnamed: D12.2, J34.1, Q9.1
unnamed: D13.1, R54.2
unnamed: D14.1, R99.2
unnamed: J4.2, R17.1
unnamed: J4.3, J7.3, JP2.2
unnamed: J5.1, Q1.1
unnamed: J6.1, Q2.3
unnamed: J7.2, R20.1
unnamed: J8.1, Q3.3
unnamed: J9.1, Q4.1
unnamed: J10.2, R25.1
unnamed: J10.3, J13.3, JP4.2
unnamed: J11.1, Q5.1
unnamed: J12.1, Q6.1
unnamed: J5.2, J9.2, J12.2, J15.2, JP3.2
unnamed: J13.2, R28.1
unnamed: J14.1, Q7.1
unnamed: J15.1, Q8.1
unnamed: J22.2, R52.2, U15.44
unnamed: J23.2, U15.43
unnamed: J23.3, U15.42
unnamed: J25.1, R55.1
unnamed: J25.2, U15.32
unnamed: J25.3, U15.33
unnamed: J25.6, R98.2
unnamed: J26.1, J27.1, J28.1, J29.1, J30.1, J31.1, JP11.2, R57.1, R58.1, R59.1, R60.1, R61.1, R62.1
unnamed: J26.3, R57.2, U16.2
unnamed: J27.3, R58.2, U16.4
unnamed: J28.3, R59.2, U16.6
unnamed: J29.3, R60.2, U16.8
unnamed: J30.3, R61.2, U16.17
unnamed: J31.3, R62.2, U16.15
unnamed: J32.1, J33.1, JP12.2
unnamed: J32.3, R63.2
unnamed: J33.3, R64.2
unnamed: J43.1, R84.1
unnamed: J43.2, R85.1
unnamed: J43.3, R86.1
unnamed: J43.4, R87.1
unnamed: J43.7, R90.1
unnamed: J43.8, R91.1
unnamed: J43.9, R92.1
unnamed: J43.10, R93.1
unnamed: J45.1, R88.1
unnamed: J45.2, R89.1
unnamed: J46.3, R94.2
unnamed: J46.4, R95.2
unnamed: J46.5, R96.2
unnamed: JP1.2, R3.1, U2.3
unnamed: JP13.2, U1.P10
unnamed: JP14.2, U1.R10
unnamed: JP15.2, U1.N10
unnamed: L2.1, U3.4
unnamed: L3.1, U4.4
unnamed: Q1.2, R16.1
unnamed: Q2.2, U7.5
unnamed: Q3.2, U7.7
unnamed: Q4.2, R19.1
unnamed: Q5.2, R23.1
unnamed: Q6.2, R24.1
unnamed: Q7.2, R29.1
unnamed: Q8.2, R30.1
unnamed: Q9.2, U17.4
unnamed: R6.2, R7.1, U3.1
unnamed: R8.2, R9.1, U4.1
unnamed: R12.2, X1.3
unnamed: R31.1, U8.23
unnamed: R32.1, U8.27
unnamed: R34.1, U9.23
unnamed: R35.1, U9.27
unnamed: R36.2, U8.14
unnamed: R37.1, U10.23
unnamed: R38.1, U10.27
unnamed: R39.2, U9.14
unnamed: R40.1, U11.23
unnamed: R41.1, U11.27
unnamed: R42.2, U10.14
unnamed: R43.1, U12.23
unnamed: R44.1, U12.27
unnamed: R45.2, U11.14
unnamed: R46.1, U13.23
unnamed: R47.1, U13.27
unnamed: R48.2, U12.14
unnamed: R49.2, U14.1, U15.18
unnamed: R50.1, U15.5
unnamed: R51.1, U15.6
unnamed: R55.2, R56.1, U15.30
unnamed: R97.2, U13.14
unnamed: R102.2, U15.29
PROGRAMN: R11.1, U1.R9, U15.2
PWM1: R14.1, U1.M16, U7.2
PWM2: R15.1, U1.M13, U7.4
PWM3: R21.1, R23.2, U1.M15
PWM4: R26.1, R29.2, U1.M14
PWM5: R13.1, R16.2, U1.T14
PWM6: R18.1, R19.2, U1.R15
PWM7: R22.1, R24.2, U1.T15
PWM8: R27.1, R30.2, U1.P15
PWM9: R17.2, U1.R12
PWM10: R20.2, U1.N12
PWM11: R25.2, U1.R13
PWM12: R28.2, U1.R14
SPI_MISO: U1.T7, U14.2, U15.40
SPI_MOSI: U1.T8, U14.5, U15.41
SPI_NSS: R10.1, R11.2, U1.P8, U15.20
SPI_SCK: U1.N9, U14.6, U15.39
STEP1: U1.G3, U10.16
STEP2: U1.E1, U9.16
STEP3: U1.B1, U8.16
STEP4: U1.E13, U13.16
STEP5: U1.F14, U12.16
STEP6: U1.H14, U11.16
UART1: R42.1, U1.G4
UART2: R39.1, U1.E3
UART3: R36.1, U1.C1
UART4: R97.1, U1.F16
UART5: R48.1, U1.F13
UART6: R45.1, U1.H13
VDDA: C48.1, C90.1, C91.1, R76.1, R77.1, R78.1, R79.1, R80.1, R81.1, R82.1, R83.1, U6.5, U15.9
WDEN: U1.G16, U17.2
WDI: C10.2, U1.G15
chain_in_in1: J45.5, U1.M1
chain_in_in2: J45.4, U1.L2
chain_in_in3: J45.3, U1.L1
chain_in_out1: R89.2, U1.K2
chain_in_out2: R88.2, U1.K1
chain_out_in1: J46.2, U1.N14
chain_out_in2: J46.1, U1.R16
chain_out_out1: R96.1, U1.P13
chain_out_out2: R95.1, U1.N13
chain_out_out3: R94.1, U1.P14
display1: J48.1, U1.A5
display2: J48.2, U1.C6
display3: J48.3, U1.B6
display4: J48.4, U1.D6
display5: J48.5, U1.A6
display6: J48.6, U1.C7
display7: J48.7, U1.C10
display8: J48.10, U1.D10
display9: J48.11, U1.B12
display10: J48.12, U1.A12
display11: J48.13, U1.B13
display12: J48.14, U1.C13
display13: J48.15, U1.D13
exp1_1: J47.4, U1.E2
exp1_2: J47.5, U1.F1
exp1_3: J47.6, U1.F2
exp1_4: J47.7, U1.G1
exp1_5: J47.8, U1.G2
exp1_6: J47.9, U1.H2
exp1_7: J47.10, U1.J1
exp1_8: J47.11, U1.J2
exp1_9: J49.11, U1.D4
exp1_10: J49.10, U1.C3
exp1_11: J49.9, U1.C4
exp1_12: J49.8, U1.C5
exp1_13: J49.7, U1.D5
exp1_14: J49.6, U1.B3
exp1_15: J49.5, U1.A3
exp1_16: J49.4, U1.B4
exp1_17: J49.3, U1.A4
exp2_1: J54.4, U1.A13
exp2_2: J54.5, U1.B15
exp2_3: J54.6, U1.B16
exp2_4: J54.7, U1.C15
exp2_5: J54.8, U1.A15
exp2_6: J54.9, U1.C16
exp2_7: J54.10, U1.D16
exp2_8: J54.11, U1.D14
exp2_9: J55.11, U1.L14
exp2_10: J55.10, U1.L15
exp2_11: J55.9, U1.L13
exp2_12: J55.8, U1.L16
exp2_13: J55.7, U1.K14
exp2_14: J55.6, U1.K15
exp2_15: J55.5, U1.K13
exp2_16: J55.4, U1.K16
exp2_17: J55.3, U1.J15
pmod1_1: R84.2, U1.R5
pmod1_2: R85.2, U1.T6
pmod1_3: R86.2, U1.T4
pmod1_4: R87.2, U1.R4
pmod2_1: R90.2, U1.R3
pmod2_2: R91.2, U1.T3
pmod2_3: R92.2, U1.T2
pmod2_4: R93.2, U1.N4
