sensille/conan_board/(commit log)

2019-11-16 Last version with tmc2660
    [conan.sch, expansion.sch, fpga.sch, input.sch, mcu.sch, power.sch, pwm.sch, stepper.sch]
2019-11-17 Replaced TMC2660 by TMC2209
    [fpga.sch, stepper.sch, tmc2660.sch]
2019-11-17 MOSFETs chosen.
    [input.sch, pwm.sch, tmc2209.sch]
2019-11-17 Annotated values in Power sheet
    [power.sch]
2019-11-17 Changed misc FETs from SIA440DJ to AON7524
    [pwm.sch]
2019-11-17 Tidy up top sheet
    [conan.sch]
2019-11-18 fixed some ERC warnings
    [expansion.sch, fpga.sch, input.sch, mcu.sch, power.sch, pwm.sch, stepper.sch, tmc2209.sch]
2019-11-18 swapped ECP5 symbol for own
    [fpga.sch, mcu.sch, power.sch]
2019-11-19 ECR done.
    [mcu.sch, power.sch]
2019-11-20 some package assignments
    [expansion.sch, fpga.sch, input.sch, mcu.sch, power.sch, pwm.sch, tmc2209.sch]
2019-11-23 Footprints done
    [expansion.sch, fpga.sch, input.sch, mcu.sch, power.sch, pwm.sch, stepper.sch, tmc2209.sch]
2019-11-23 Netlist import to PCB
    [conan.kicad_pcb, fpga.sch, power.sch]
2019-11-23 Recovery after crash, replace double row pin header for expansion by 2 separate single row headers
    [conan.kicad_pcb, expansion.sch]
2019-11-23 rough placement
    [conan.kicad_pcb, expansion.sch, input.sch, pwm.sch, tmc2209.sch]
2019-11-23 better footprints for restistors and capacitors
    [conan.kicad_pcb, expansion.sch, fpga.sch, input.sch, mcu.sch, power.sch, pwm.sch, tmc2209.sch]
2019-11-23 More footprint updates, removed individual ENN pullups for drivers
    [conan.kicad_pcb, stepper.sch, tmc2209.sch]
2019-11-24 routing sketch for stepper driver
    [conan.kicad_pcb, input.sch, tmc2209.sch]
2019-11-24 rough reassignment of fpga-pads to account for the direction in which the wires go. Only assign to outer 4 rings for easier escape routing.
    [conan.kicad_pcb, fpga.sch, power.sch]
2019-11-24 more reassignments
    [conan.kicad_pcb, fpga.sch]
2019-11-24 clean start for escape routing
    [conan.kicad_pcb]
2019-11-25 some escape routing
    [conan.kicad_pcb, fpga.sch]
2019-11-26 more escape routing
    [conan.kicad_pcb, fpga.sch]
2019-11-26 Escape routing done.
    [conan.kicad_pcb, fpga.sch]
2019-11-27 snapshot before going from 0402 to 0603
    [conan.kicad_pcb]
2019-11-27 fixed an error in tmc2209 schematic, finished routing one driver
    [conan.kicad_pcb, expansion.sch, fpga.sch, input.sch, mcu.sch, power.sch, pwm.sch, stepper.sch]
2019-11-28 2./3. driver in progress
    [conan.kicad_pcb, tmc2209.sch]
2019-11-30 stepper driver done
    [conan.kicad_pcb]
2019-11-30 dc-dc converter
    [conan.kicad_pcb, pwm.sch, tmc2209.sch]
2019-12-01 placement roughly done
    [conan.kicad_pcb, expansion.sch, fpga.sch, mcu.sch]
2019-12-01 routing snapshot
    [conan.kicad_pcb, fpga.sch, tmc2209.sch]
2019-12-01 reassign some FPGA pins for ease of routing
    [conan.kicad_pcb, fpga.sch, tmc2209.sch]
2019-12-03 more routing
    [conan.kicad_pcb, fpga.sch, tmc2209.sch]
2019-12-08 power routing done
    [conan.kicad_pcb]
2019-12-09 more remapping/routing
    [conan.kicad_pcb, fpga.sch]
2019-12-10 all traces connected
    [conan.kicad_pcb, fpga.sch]
2019-12-12 DRC done. Silk adjusted.
    [conan.kicad_pcb]
2019-12-12 more beautification
    [conan.kicad_pcb]
2019-12-12 some nitpicks
    [conan.kicad_pcb, power.sch]
2019-12-12 nitpicks, usb shield via R to GND
    [conan.kicad_pcb, input.sch, mcu.sch]
2019-12-12 amend last commit
    [conan.kicad_pcb, mcu.sch]
2019-12-12 added some labels to silk
    [conan.kicad_pcb]
2019-12-12 remove voltage divider for uart, as PA15 is 5V-tolerant anyway.
    [conan.kicad_pcb, mcu.sch]
2019-12-12 move 5th mounting hole more to center of board
    [conan.kicad_pcb]
2019-12-12 first prototype version
    [conan.kicad_pcb]
2020-01-10 small fix, ordered this version
    [conan.kicad_pcb]
2020-01-11 consolidate values to get a clearer BOM
    [conan.kicad_pcb, expansion.sch, fpga.sch, input.sch, mcu.sch, power.sch, pwm.sch, stepper.sch]
2021-03-19 added pdf export of schematics
